Peace-ADIKEPETO/ExtDE0_7Seg-KiCad/7Seg_Ext.csv

Reference | Qty | Value | DNP | Exclude from BOM | Exclude from Board | Exclude from Simulation | Exclude from Position Files | Footprint | Datasheet
D1,D2,D3,D4,D5,D6,D7,D8,D9,D10,D11,D12 | 12 | LED |  |  |  |  | ${EXCLUDE_FROM_POS_FILES} | LED_THT:LED_D3.0mm
J1 | 1 | Conn_02x20_Odd_Even |  |  |  |  | ${EXCLUDE_FROM_POS_FILES} | Connector_PinSocket_2.54mm:PinSocket_2x20_P2.54mm_Vertical
Q1,Q6,Q7,Q8,Q9,Q10,Q11,Q12,Q13,Q14,Q15,Q16 | 12 | IRF9520 |  |  |  |  | ${EXCLUDE_FROM_POS_FILES} | Package_TO_SOT_THT:TO-220-3_Vertical
Q2,Q3,Q4,Q5 | 4 | 2N7000 |  |  |  |  | ${EXCLUDE_FROM_POS_FILES} | Package_TO_SOT_THT:TO-92_Inline | https://www.vishay.com/docs/70226/70226.pdf
R1,R2,R3,R4,R5,R6,R7,R8,R13,R16,R18,R20,R22,R24,R26,R28 | 16 | 330R |  |  |  |  | ${EXCLUDE_FROM_POS_FILES} | Resistor_THT:R_Axial_DIN0207_L6.3mm_D2.5mm_P10.16mm_Horizontal
R9,R10,R11,R12 | 4 | 100R |  |  |  |  | ${EXCLUDE_FROM_POS_FILES} | Resistor_THT:R_Axial_DIN0207_L6.3mm_D2.5mm_P7.62mm_Horizontal
R14,R15,R17,R19,R21,R23,R25,R27,R29,R32,R34,R36 | 12 | 1K |  |  |  |  | ${EXCLUDE_FROM_POS_FILES} | Resistor_THT:R_Axial_DIN0207_L6.3mm_D2.5mm_P7.62mm_Horizontal
R30,R31,R33,R35,R37,R38,R39,R40,R41 | 9 | 4.7K |  |  |  |  | ${EXCLUDE_FROM_POS_FILES} | Resistor_THT:R_Axial_DIN0207_L6.3mm_D2.5mm_P7.62mm_Horizontal
SW1 | 1 | SW_DIP_x08 |  |  |  |  | ${EXCLUDE_FROM_POS_FILES} | Button_Switch_THT:SW_DIP_SPSTx08_Slide_9.78x22.5mm_W7.62mm_P2.54mm
SW2,SW3,SW4,SW5 | 4 | SW_Push |  |  |  |  | ${EXCLUDE_FROM_POS_FILES} | Button_Switch_THT:SW_PUSH_6mm
SW6 | 1 | SMD-BUTTON_6P-10X10X8.6MM_ |  |  |  |  | ${EXCLUDE_FROM_POS_FILES} | SnapEDA:SW6-3.25-10X10X8.6MM
U1 | 1 | CC56-12EWA |  |  |  |  | ${EXCLUDE_FROM_POS_FILES} | Display_7Segment:CA56-12EWA | http://www.kingbrightusa.com/images/catalog/SPEC/CA56-12EWA.pdf
