Peace-ADIKEPETO/ExtDE0_7Seg-KiCad/7Seg_Ext.step

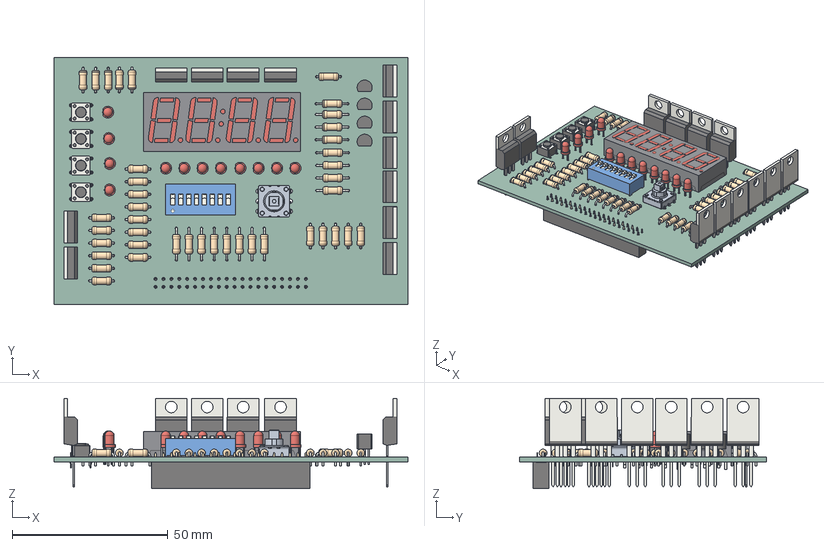
[picture p4: CAD file, 2026-10-20]
7Seg_Ext.step
113.7 x 79.3 x 29.0 mm
R_Axial_DIN0207_L63mm_D25mm_P762mm_Horizontal x 25
SW_PUSH_6mm x 4
TO-220-3_Vertical x 12
LED_D3.0mm x 12
TO-92_Inline_Narrow x 4
R_Axial_DIN0207_L63mm_D25mm_P1016mm_Horizontal x 16
Body_sp
SW_DIP_SPSTx08_Slide_978x225mm_W762mm_P254mm
PinSocket_2x20_P2.54mm_Vertical
7Se13B9_PCB
