Peace-ADIKEPETO/ExtDE0_7Seg-KiCad/(list of files, cad)

Other CAD files:
7Seg_Ext.stl
