Peace-ADIKEPETO/ExtDE0_7Seg-KiCad/docs/ExtDE0_7Seg.PDF

Comment | Description | Designator | Footprint | LibRef | Quantity
LED_Y | | D1 | D_0603_LED_Y | LED_Y | 1
LED_G | | D2 | D_0603_LED_G | LED_G | 1
LED_O | | D3 | D_0603_LED_O | LED_O | 1
LED_R | | D4, D5, D6, D7, D8, D9, D10, D11, D12 | D_0603_LED_R | LED_R | 9
Header 20X2 | Header, 20-Pin, Dual row | P1 | Header 40p 2x20 hole F, fem Draw | Header 20X2 | 1
0 | Resistor | R1, R2, R4, R5, R8, R9 | R_0603-thin | Res2 | 6
1K | Resistor | R3 | R_0603-thin | Res2 | 1
56 | ResNet x4 | R6, R7 | RESNETX4_0603_3216 M | Rx4_0603_3216M | 2
4.7k | Resistor | R10, R11, R12, R13, R14, R15, R17, R19, R21 | R_0603 | Res2 | 9
1k | Resistor | R16, R20, R22 | R_0603 | Res2 | 3
560 | Resistor | R18 | R_0603 | Res2 | 1
1k | ResNet x4 | R23, R25 | ResNetx4_0603_3216M | Rx4_0603_3216M | 2
330 | ResNet x4 | R24, R26, R27, R28 | ResNetx4_0603_3216M | Rx4_0603_3216M | 4
100 | Resistor | R29, R30, R31, R32, R33, R34 | R_0603-thin | Res2 | 6
SKQUDBE010 | SKQUDBE010-ALPS | S1 | SKQUDBE010 | Joystick_5P | 1
PushButton1_4p | [NoValue], [NoValue], [NoValue], PushButton | S2, S3, S4, S5 | FSM4JSMA | PushButton1_4p | 4
Switch8p_On_Tri_On | | S6 | SOP254P990X265-16N | Switch8p_On_Tri_On | 1
pMOS | | T1, T2, T3, T4, T5, T6 | SSSMINI3-F2-B | pMOS | 6
nMOS | | T7, T8, T9, T10, T11, T12, T13, T14, T15, T16, T17, T18, T19, T20 | SSSMINI3-F2-B | nMOS | 14
TP | | TP1, TP2 | TP_0.75mm | TP | 2
7SEG_6Digit_KEM-3061-ASR | | U1 | 7SEG_6DIGI_7.68MM | 7SEG_6Digit_KEM-3061-ASR | 1
7SEG_4Digit_LTC4627JR 7SEG 4DIGI Annode CommU2 | | | 7SEG_4DIGI_10MM_LTC7SEG_4 Digit_LTC4627JR | | 1

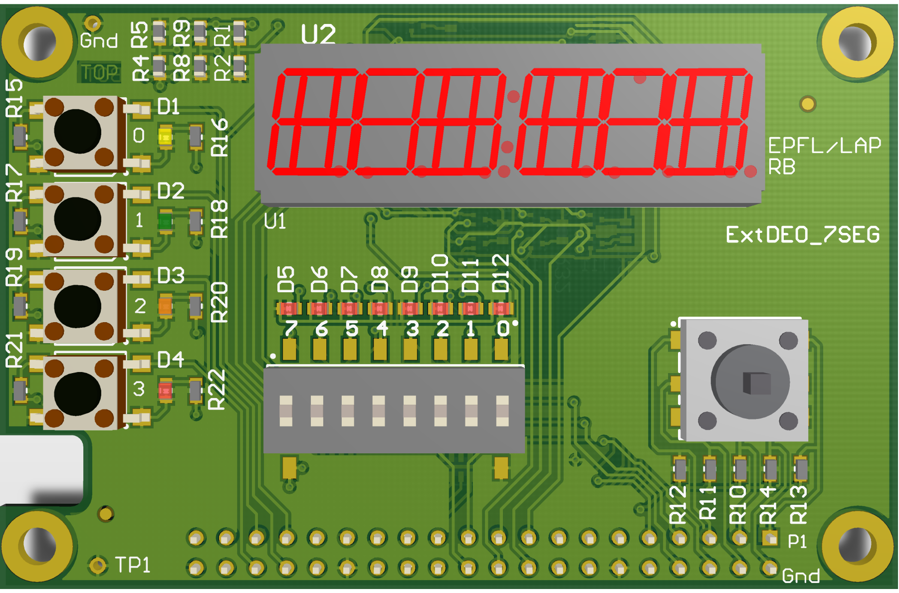
[picture p5: page 2]

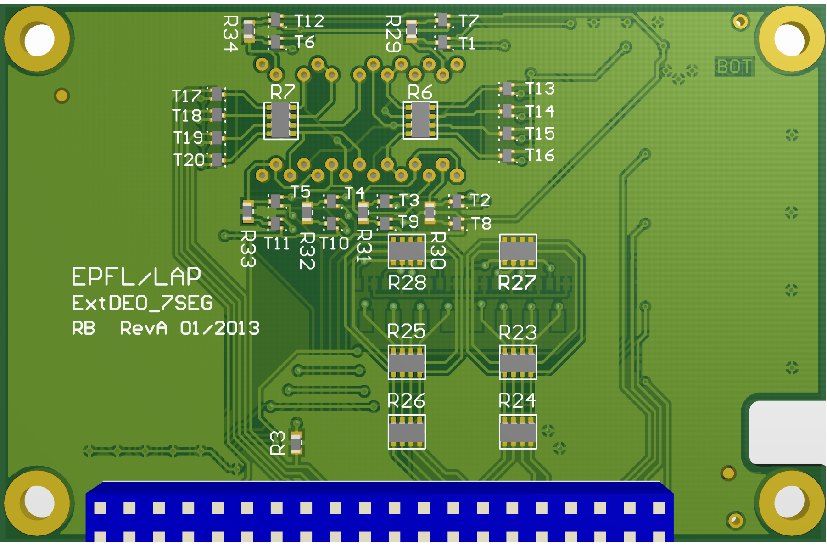
[picture p6: page 3]

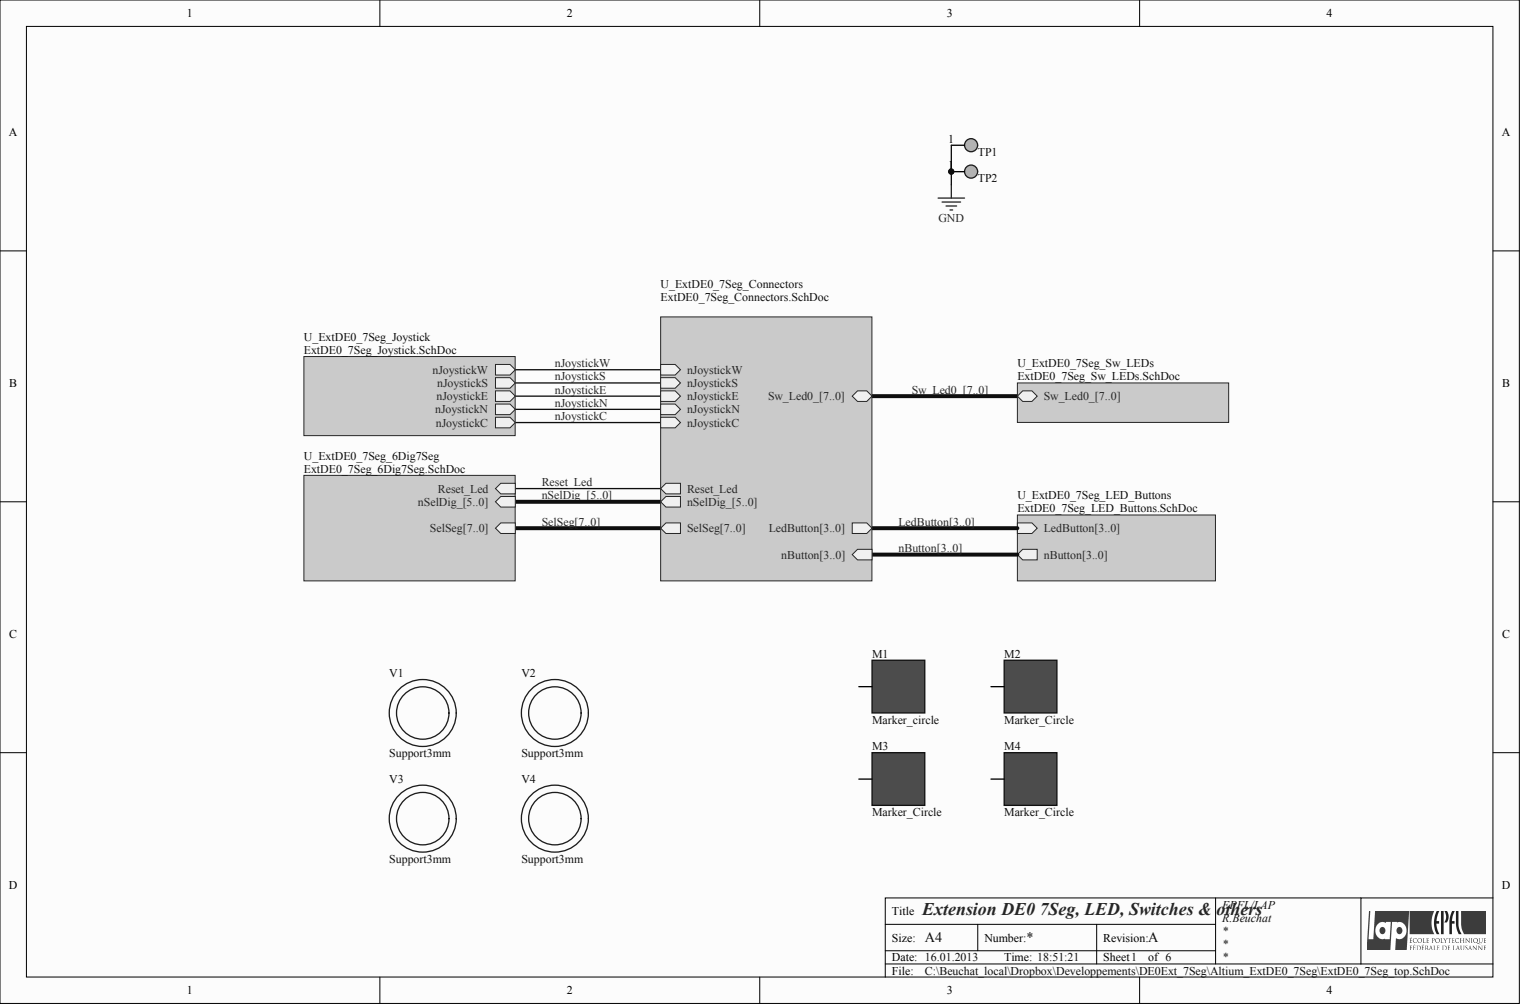
[picture p7: page 4]

Extension DE0 7Seg, LED, Switches & others Title | EPFL/LAP R.Beuchat * *

A4 Size: | * Number: | A Revision:
Date: 16.01.2013 Time: 18:51:21 | | Sheet of 6

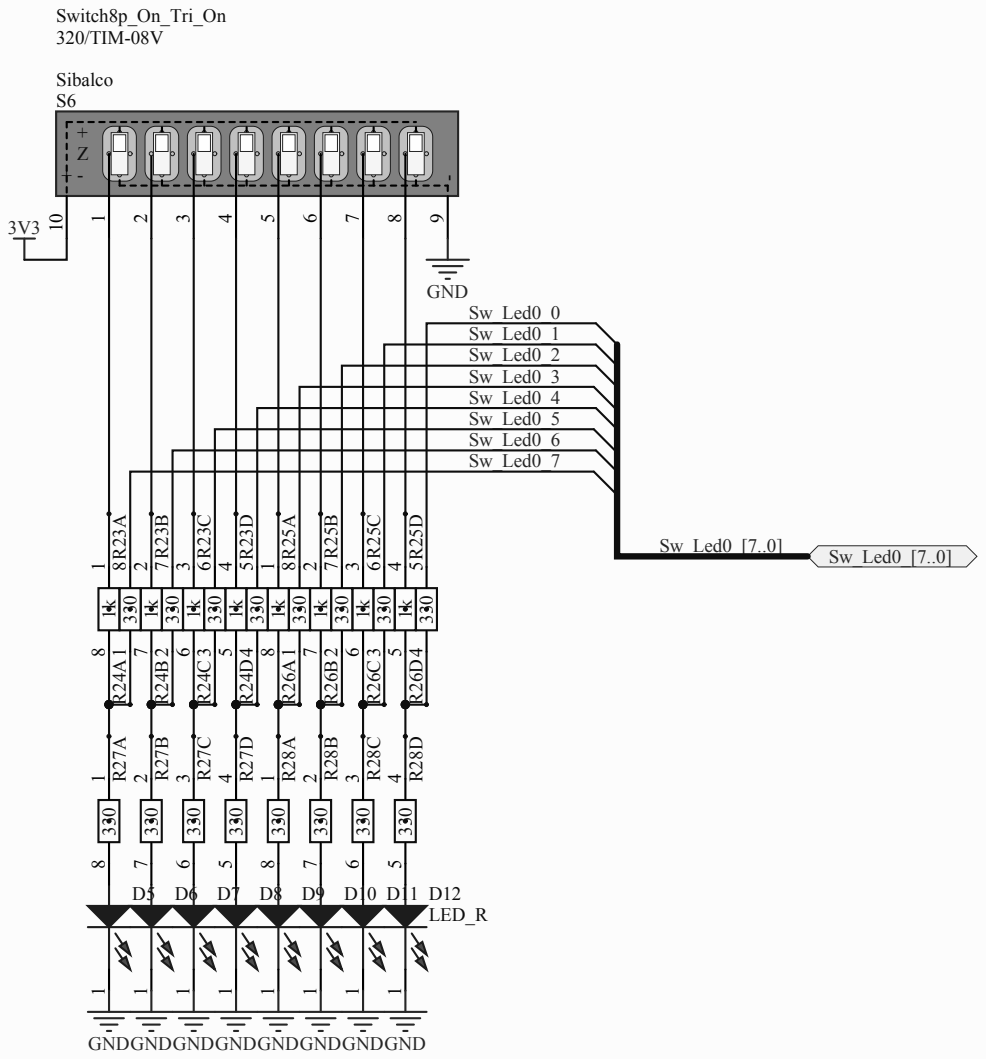
[picture p8: page 5]

Sw_Led0_2
Sw_Led0_3
Sw_Led0_4
Sw_Led0_5
Sw_Led0_6
Sw_Led0_7

Extension DE0 LED, Switches & others Title | EPFL/LAP R.Beuchat *

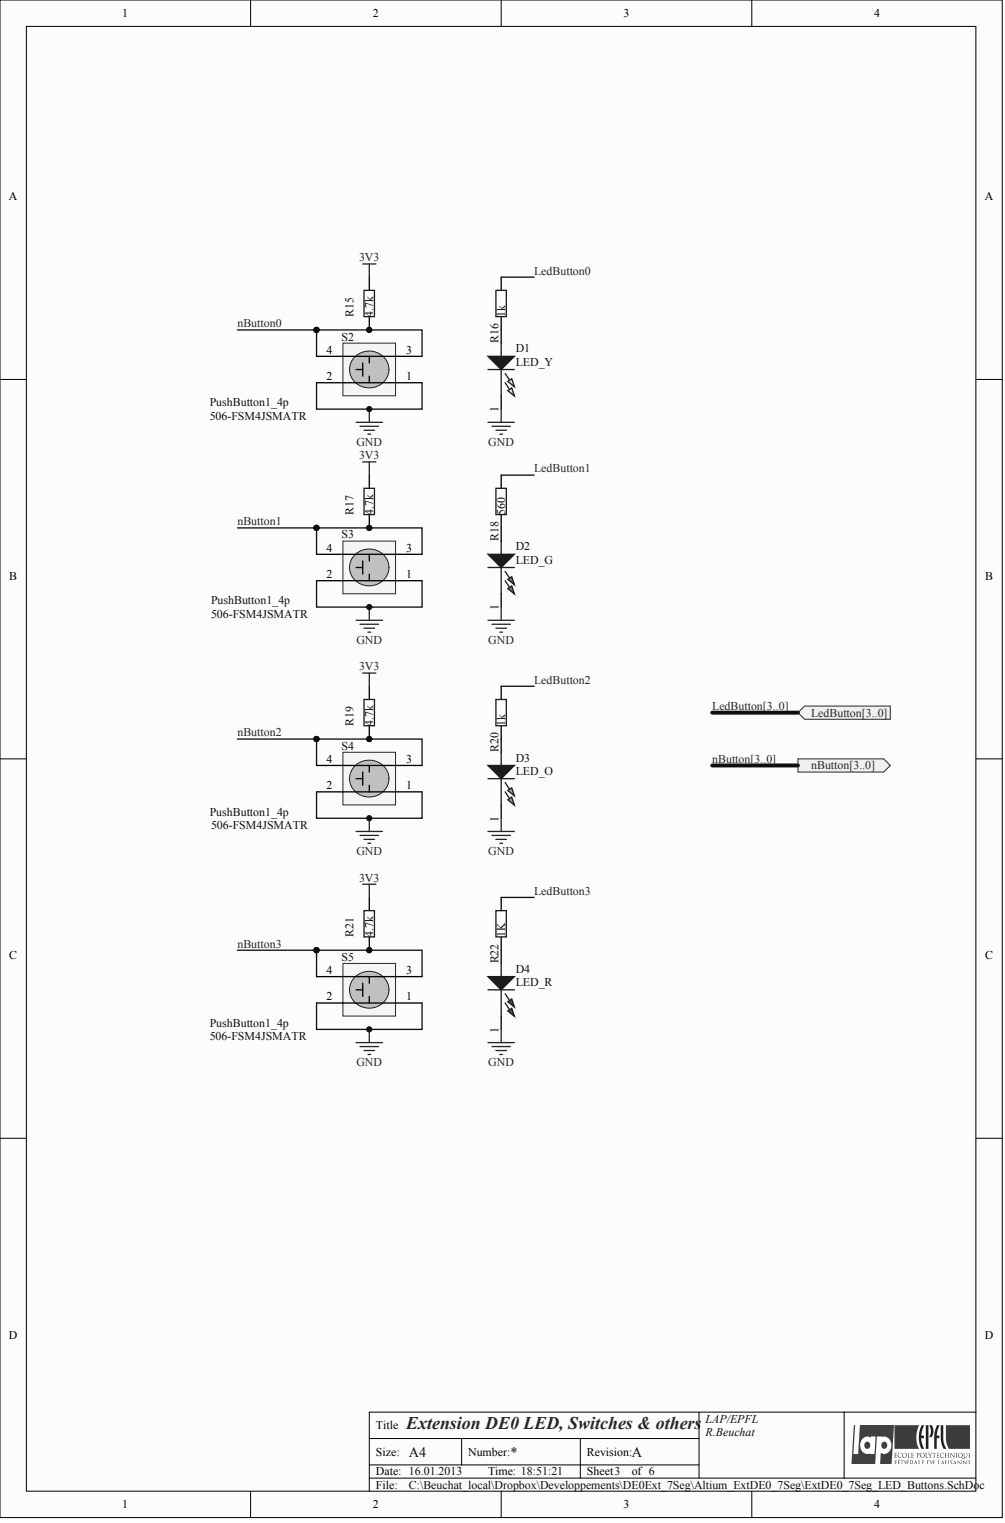
[picture p9: page 6]

Extension DE0 LED, Switches & others | LAP/EPFL R.Beuchat

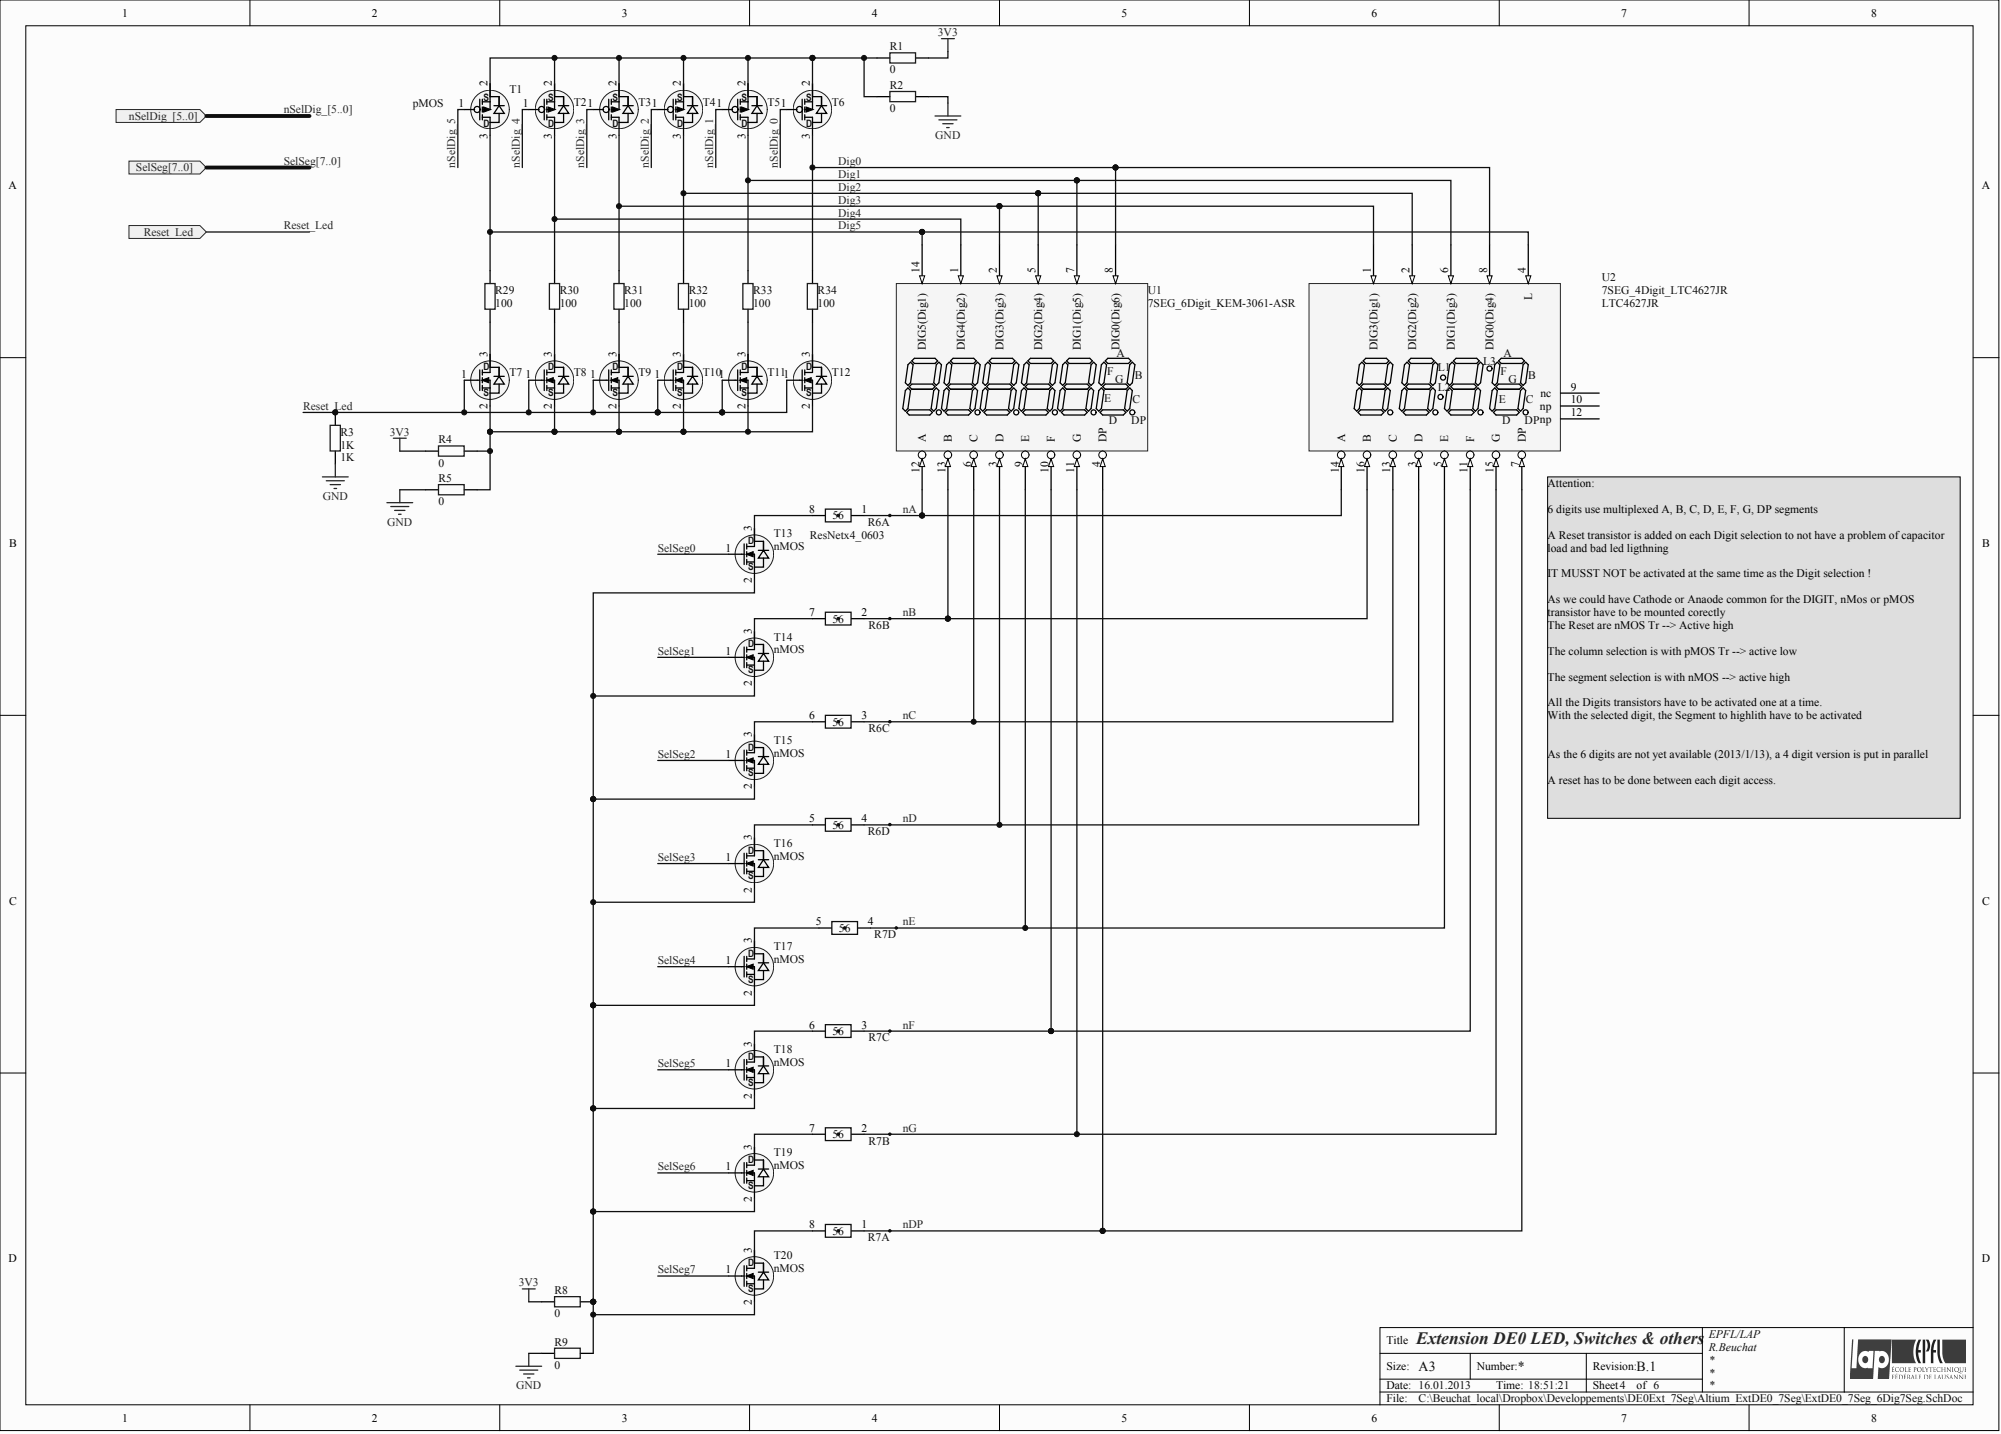
[picture p10: page 7]

Dig 1
Dig 2
Dig 3
Dig 4
Dig 5

6 digits use multiplexed A, B, C, D, E, F, G, DP seg

A Reset transistor is added on each Digit selection to not have a problem of capacitor
load and bad led ligthning IT MUSST NOT be activated at the same time as the Digit selection !

As we could have Cathode or Anaode com
transistor have to be mounted corectly
The Reset are nMOS Tr -

mon for the DIGIT, nMos or pMOS

The column selection is with pMOS Tr -

ment selection is with nMOS -

All the Digits transistors have to be activated one at a time.
With the selected digit, the Seg

ment to highlith have to be activated

As the 6 digits are not yet available (2013/1/13), a 4 digit version is put in parallel

A reset has to be done between each digit access.

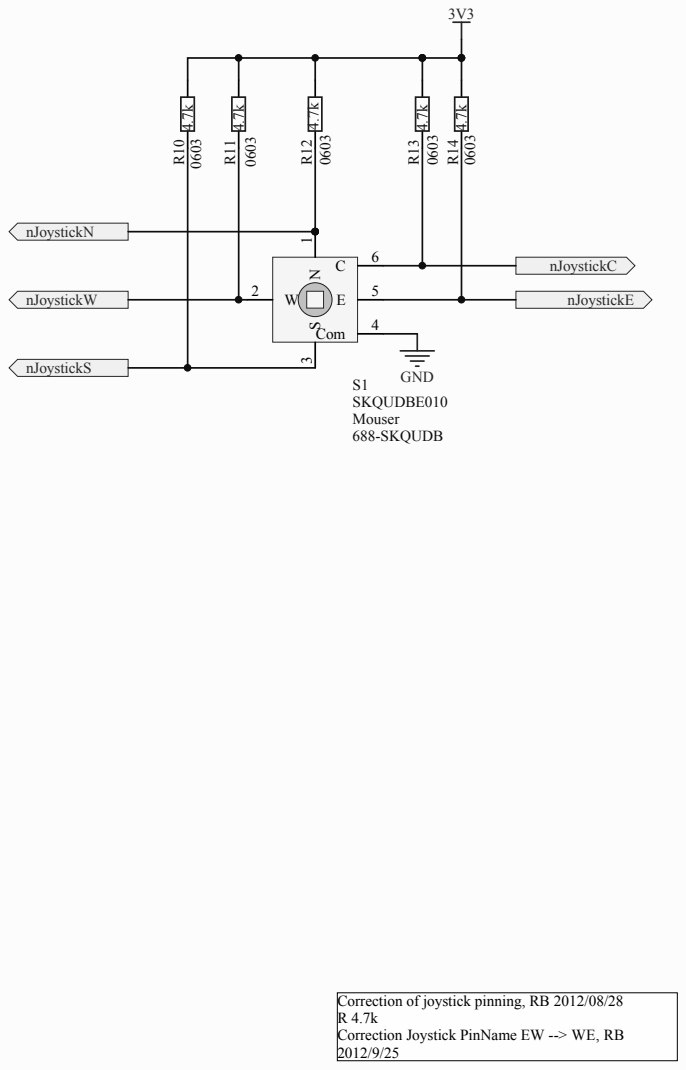
[picture p11: page 8]

Correction of joystick pinning, RB 2012/08/28
Correction Joystick PinName EW --> WE, RB

Extension DE0 LED, Switches & others | LAP/EPFL R.Beuchat Joystick

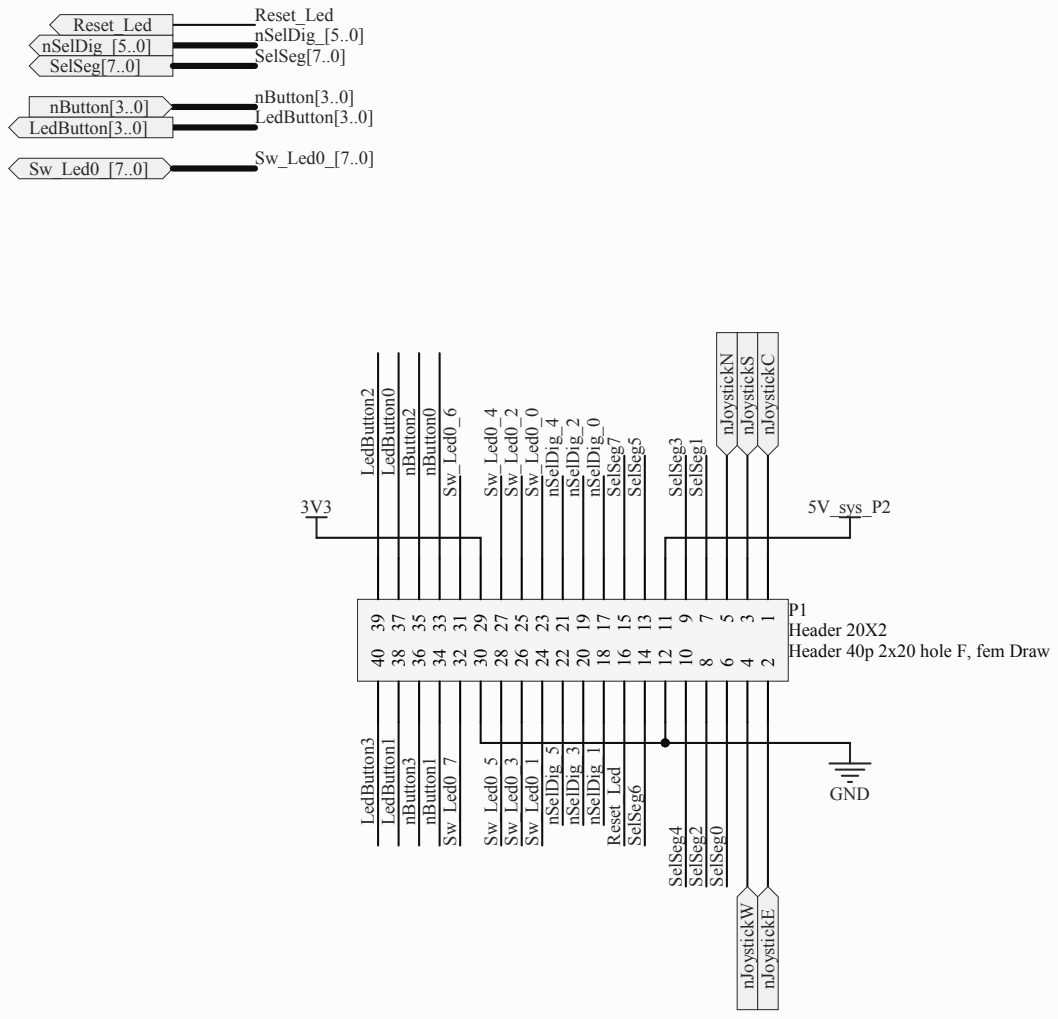
[picture p12: page 9]

Extension DE0 7Seg, Switches & others Title | EPFL/LAP R.Beuchat *
