Peace-ADIKEPETO/ExtDE0_7Seg-KiCad/7Seg_Ext-B_Cu.pdf

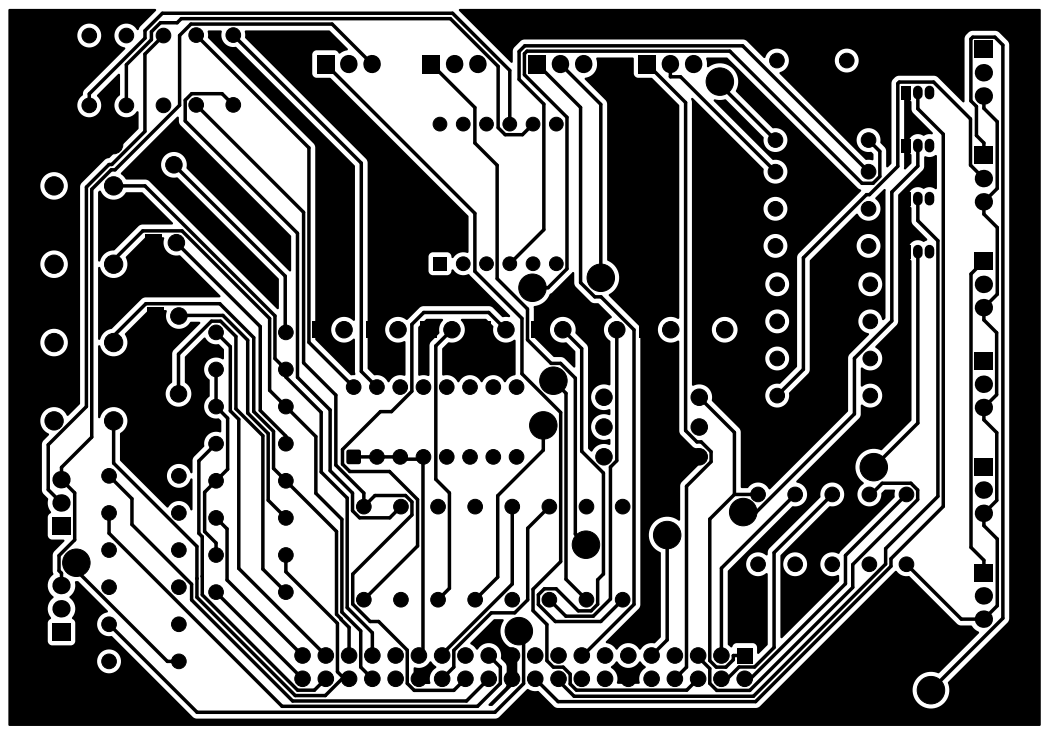
[picture p13: page 1]
