Peace-ADIKEPETO/ExtDE0_7Seg-KiCad/7Seg_Ext-B_Mask.pdf

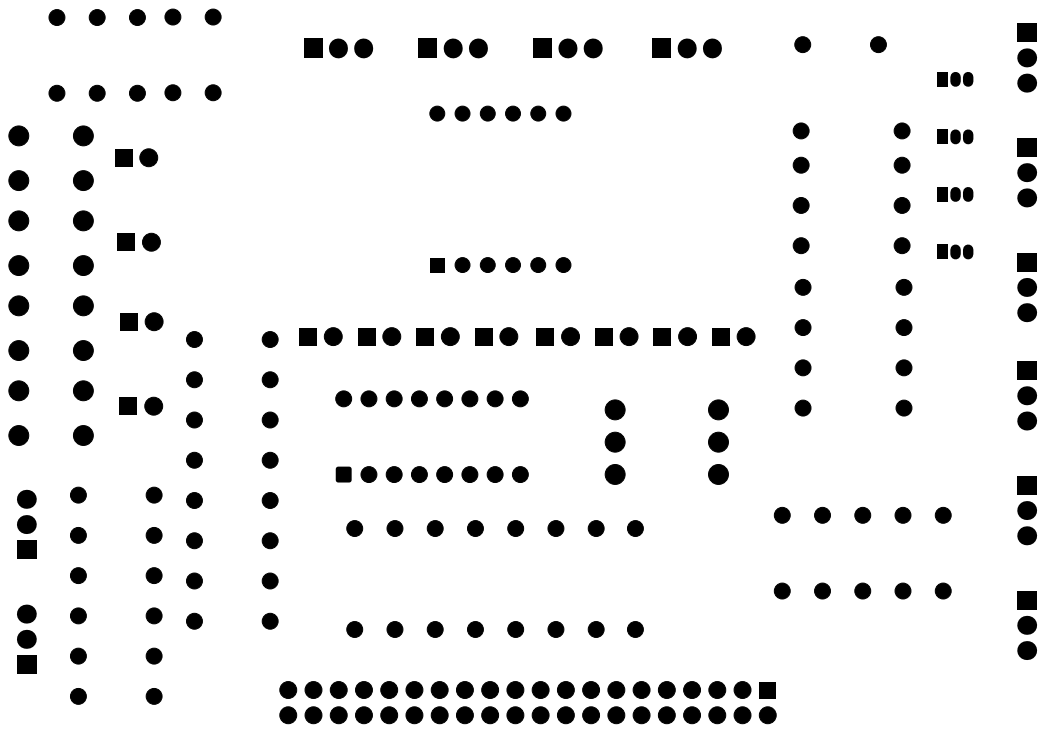
[picture p14: page 1]
