Peace-ADIKEPETO/ExtDE0_7Seg-KiCad/7Seg_Ext-F_Cu.pdf

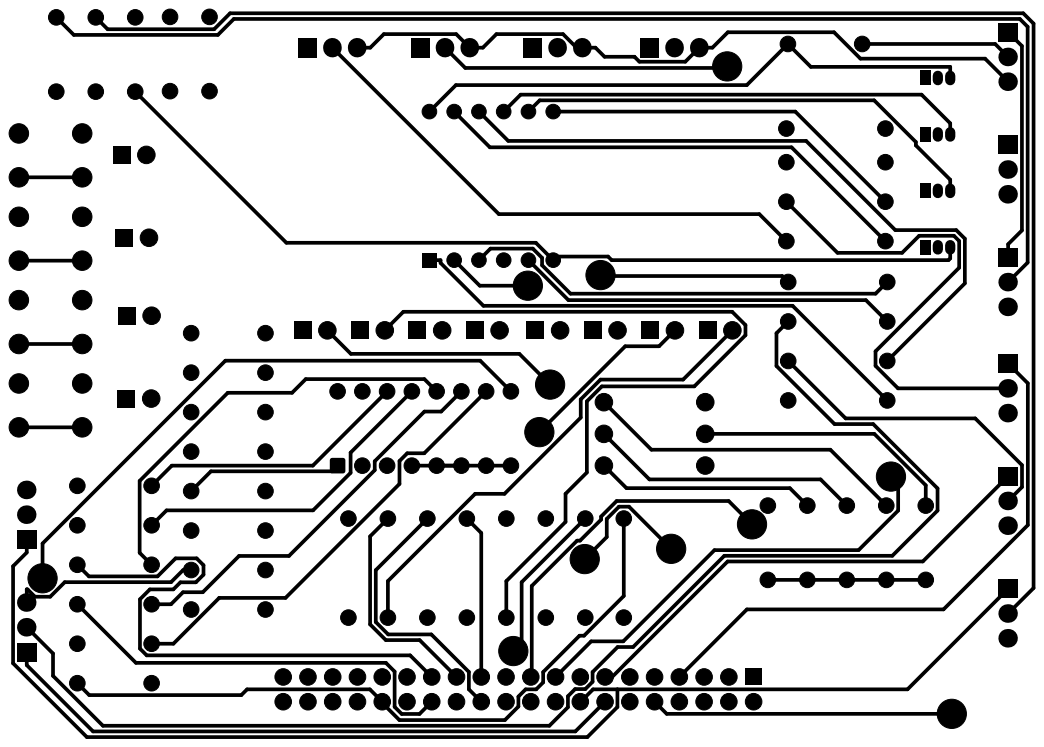
[picture p15: page 1]
