Peace-ADIKEPETO/ExtDE0_7Seg-KiCad/7Seg_Ext-F_Silkscreen.pdf

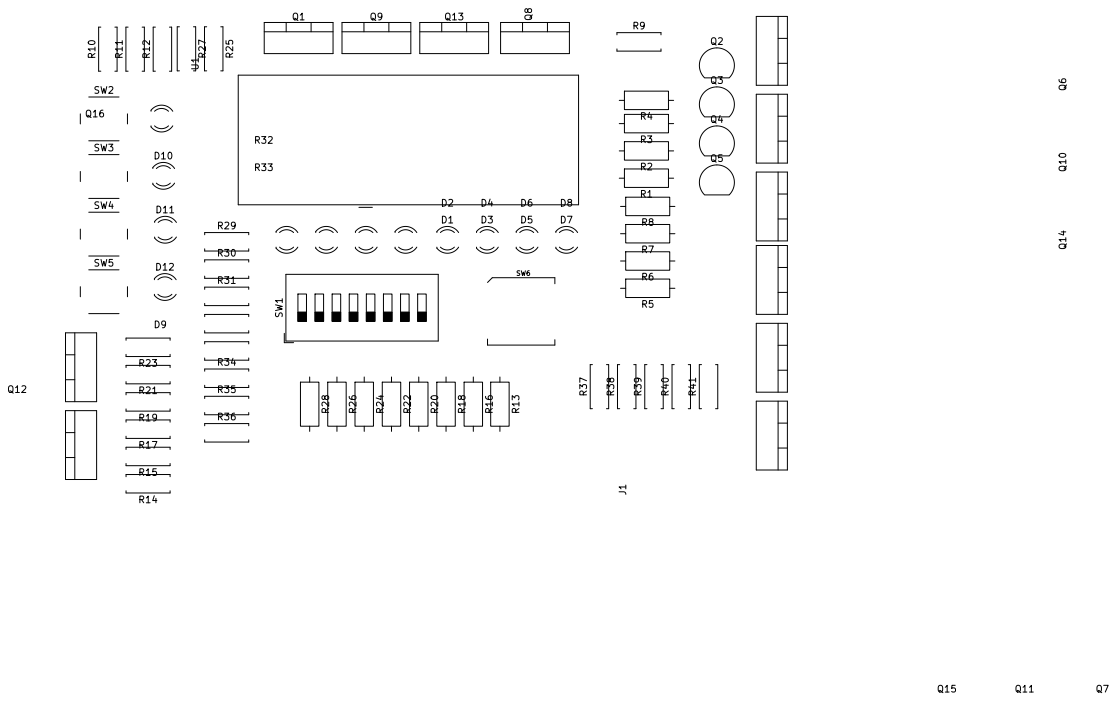
[picture p16: page 1]
