Peace-ADIKEPETO/ExtDE0_7Seg-KiCad/(list of files, drawings)

Other design files:
temp-freerouting.dsn
