Peace-ADIKEPETO/ExtDE0_7Seg-KiCad/7Seg_Ext.kicad_pcb

## KiCad design 7Seg_Ext.kicad_pcb (2026-10-20)

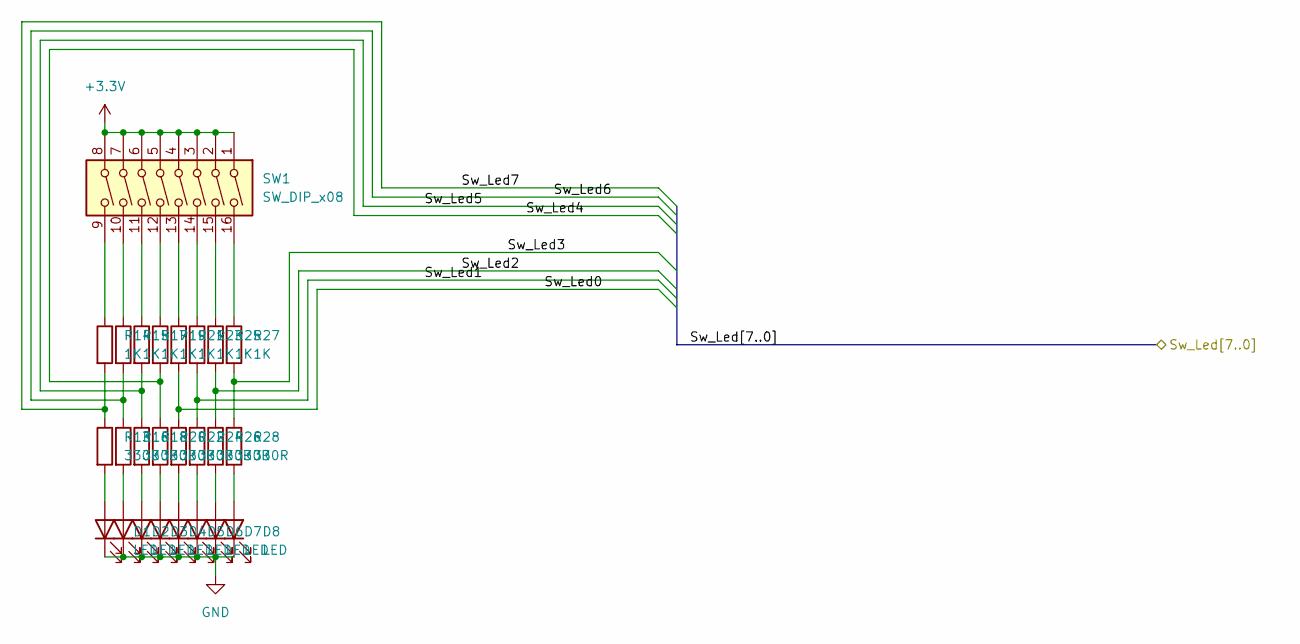
[picture p17: schematic Sheet2.kicad_sch]

Parts:
D1, D2, D3, D4, D5, D6, D7, D8: LED; LED_D3.0mm
R13, R16, R18, R20, R22, R24, R26, R28: 330R; R_Axial_DIN0207_L6.3mm_D2.5mm_P10.16mm_Horizontal
R14, R15, R17, R19, R21, R23, R25, R27: 1K; R_Axial_DIN0207_L6.3mm_D2.5mm_P7.62mm_Horizontal
SW1: SW_DIP_x08; SW_DIP_SPSTx08_Slide_9.78x22.5mm_W7.62mm_P2.54mm

Connections:
+3.3V: SW1.1, SW1.2, SW1.3, SW1.4, SW1.5, SW1.6, SW1.7, SW1.8; also elsewhere on the board
/Sw_Led0: R21.2, R22.1; also elsewhere on the board
/Sw_Led1: R23.2, R24.1; also elsewhere on the board
/Sw_Led2: R25.2, R26.1; also elsewhere on the board
/Sw_Led3: R27.2, R28.1; also elsewhere on the board
/Sw_Led4: R19.2, R20.1; also elsewhere on the board
/Sw_Led5: R17.2, R18.1; also elsewhere on the board
/Sw_Led6: R15.2, R16.1
/Sw_Led7: R13.1, R14.2; also elsewhere on the board
GND: D1.1 (K), D2.1 (K), D3.1 (K), D4.1 (K), D5.1 (K), D6.1 (K), D7.1 (K), D8.1 (K); also elsewhere on the board
unnamed: D1.2 (A), R13.2
unnamed: D2.2 (A), R16.2
unnamed: D3.2 (A), R18.2
unnamed: D4.2 (A), R20.2
unnamed: D5.2 (A), R22.2
unnamed: D6.2 (A), R24.2
unnamed: D7.2 (A), R26.2
unnamed: D8.2 (A), R28.2
unnamed: R14.1, SW1.9
unnamed: R15.1, SW1.10
unnamed: R17.1, SW1.11
unnamed: R19.1, SW1.12
unnamed: R21.1, SW1.13
unnamed: R23.1, SW1.14
unnamed: R25.1, SW1.15
unnamed: R27.1, SW1.16

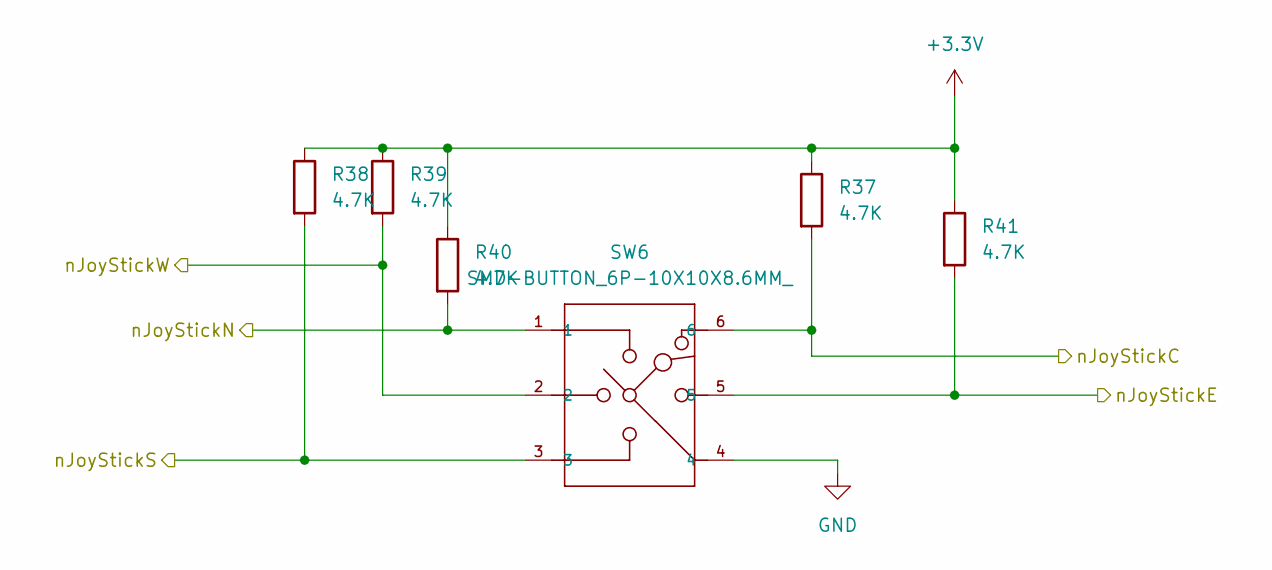
[picture p18: schematic Sheet4.kicad_sch]

Parts:
R37, R38, R39, R40, R41: 4.7K; R_Axial_DIN0207_L6.3mm_D2.5mm_P7.62mm_Horizontal
SW6: SMD-BUTTON_6P-10X10X8.6MM_; SW6-3.25-10X10X8.6MM

Connections:
+3.3V: R37.1, R38.1, R39.1, R40.1, R41.1; also elsewhere on the board
/nJoyStickC: R37.2, SW6.6; also elsewhere on the board
/nJoyStickE: R41.2, SW6.5; also elsewhere on the board
/nJoyStickN: R40.2, SW6.1; also elsewhere on the board
/nJoyStickS: R38.2, SW6.3; also elsewhere on the board
/nJoyStickW: R39.2, SW6.2; also elsewhere on the board
GND: SW6.4; also elsewhere on the board

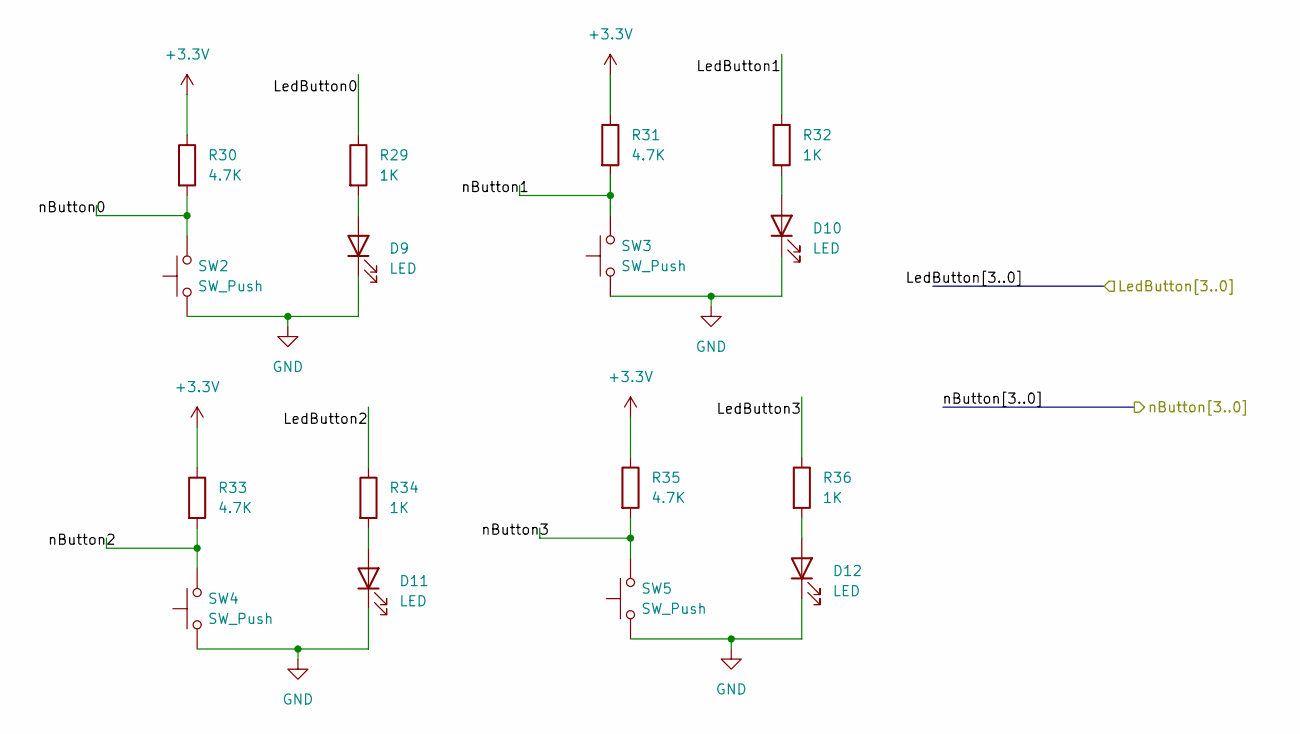
[picture p19: schematic Sheet3.kicad_sch]

Parts:
D9, D10, D11, D12: LED; LED_D3.0mm
R29, R32, R34, R36: 1K; R_Axial_DIN0207_L6.3mm_D2.5mm_P7.62mm_Horizontal
R30, R31, R33, R35: 4.7K; R_Axial_DIN0207_L6.3mm_D2.5mm_P7.62mm_Horizontal
SW2, SW3, SW4, SW5: SW_Push; SW_PUSH_6mm

Connections:
+3.3V: R30.1, R31.1, R33.1, R35.1; also elsewhere on the board
/LedButton0: R29.1; also elsewhere on the board
/LedButton1: R32.1; also elsewhere on the board
/LedButton2: R34.1; also elsewhere on the board
/LedButton3: R36.1; also elsewhere on the board
/nButton0: R30.2, SW2.2; also elsewhere on the board
/nButton1: R31.2, SW3.2; also elsewhere on the board
/nButton2: R33.2, SW4.2; also elsewhere on the board
/nButton3: R35.2, SW5.2; also elsewhere on the board
GND: D9.1 (K), D10.1 (K), D11.1 (K), D12.1 (K), SW2.1, SW3.1, SW4.1, SW5.1; also elsewhere on the board
unnamed: D9.2 (A), R29.2
unnamed: D10.2 (A), R32.2
unnamed: D11.2 (A), R34.2
unnamed: D12.2 (A), R36.2

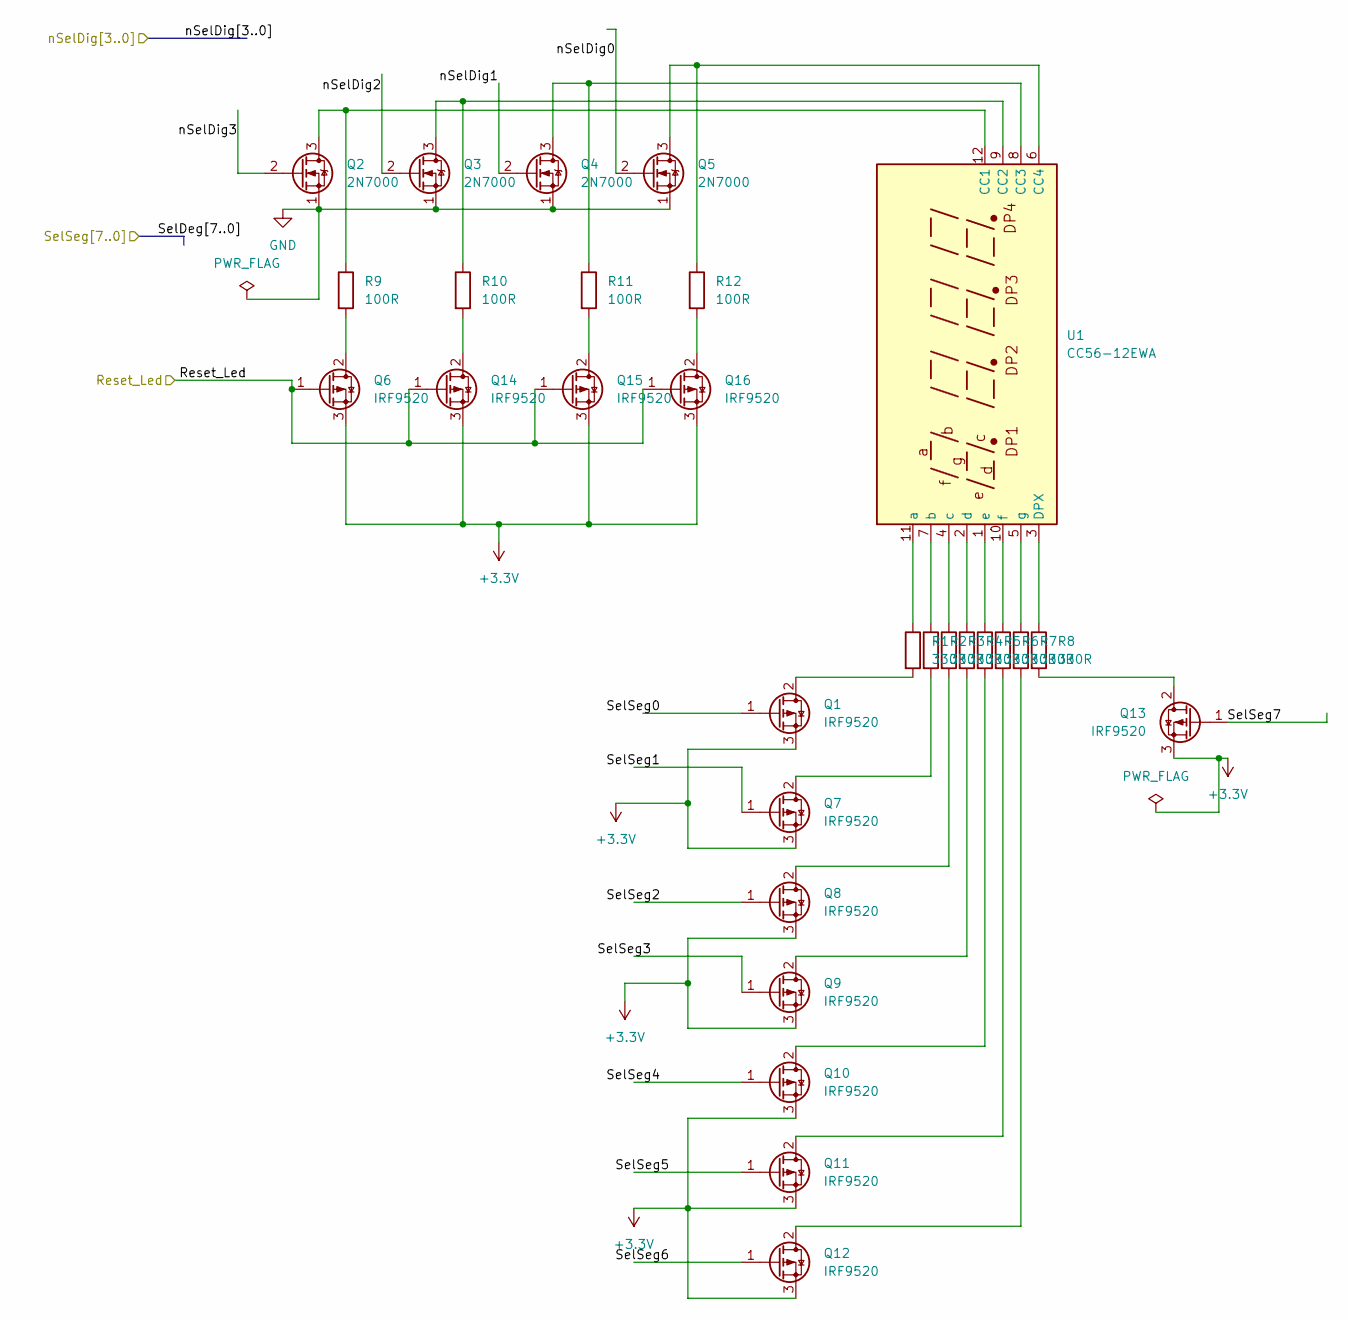
[picture p20: schematic Sheet1.kicad_sch]

Parts:
Q1, Q6, Q7, Q8, Q9, Q10, Q11, Q12, Q13, Q14, Q15, Q16: IRF9520; TO-220-3_Vertical
Q2, Q3, Q4, Q5: 2N7000; TO-92_Inline
R1, R2, R3, R4, R5, R6, R7, R8: 330R; R_Axial_DIN0207_L6.3mm_D2.5mm_P10.16mm_Horizontal
R9, R10, R11, R12: 100R; R_Axial_DIN0207_L6.3mm_D2.5mm_P7.62mm_Horizontal
U1: CC56-12EWA; CA56-12EWA

Connections:
+3.3V: Q1.3 (S), Q6.3 (S), Q7.3 (S), Q8.3 (S), Q9.3 (S), Q10.3 (S), Q11.3 (S), Q12.3 (S), Q13.3 (S), Q14.3 (S), Q15.3 (S), Q16.3 (S); also elsewhere on the board
/Reset_Led: Q6.1 (G), Q14.1 (G), Q15.1 (G), Q16.1 (G); also elsewhere on the board
/SelSeg0: Q1.1 (G); also elsewhere on the board
/SelSeg1: Q7.1 (G); also elsewhere on the board
/SelSeg2: Q8.1 (G); also elsewhere on the board
/SelSeg3: Q9.1 (G); also elsewhere on the board
/SelSeg4: Q10.1 (G); also elsewhere on the board
/SelSeg5: Q11.1 (G); also elsewhere on the board
/SelSeg6: Q12.1 (G); also elsewhere on the board
/SelSeg7: Q13.1 (G); also elsewhere on the board
/nSelDig0: Q5.2 (G); also elsewhere on the board
/nSelDig1: Q4.2 (G); also elsewhere on the board
/nSelDig2: Q3.2 (G); also elsewhere on the board
/nSelDig3: Q2.2 (G); also elsewhere on the board
GND: Q2.1 (S), Q3.1 (S), Q4.1 (S), Q5.1 (S); also elsewhere on the board
unnamed: Q1.2 (D), R1.2
unnamed: Q2.3 (D), R9.1, U1.12 (CC1)
unnamed: Q3.3 (D), R10.1, U1.9 (CC2)
unnamed: Q4.3 (D), R11.1, U1.8 (CC3)
unnamed: Q5.3 (D), R12.1, U1.6 (CC4)
unnamed: Q6.2 (D), R9.2
unnamed: Q7.2 (D), R2.2
unnamed: Q8.2 (D), R3.2
unnamed: Q9.2 (D), R4.2
unnamed: Q10.2 (D), R5.2
unnamed: Q11.2 (D), R6.2
unnamed: Q12.2 (D), R7.2
unnamed: Q13.2 (D), R8.2
unnamed: Q14.2 (D), R10.2
unnamed: Q15.2 (D), R11.2
unnamed: Q16.2 (D), R12.2
unnamed: R8.1, U1.3 (DPX)
unnamed: R1.1, U1.11 (a)
unnamed: R2.1, U1.7 (b)
unnamed: R3.1, U1.4 (c)
unnamed: R4.1, U1.2 (d)
unnamed: R5.1, U1.1 (e)
unnamed: R6.1, U1.10 (f)
unnamed: R7.1, U1.5 (g)

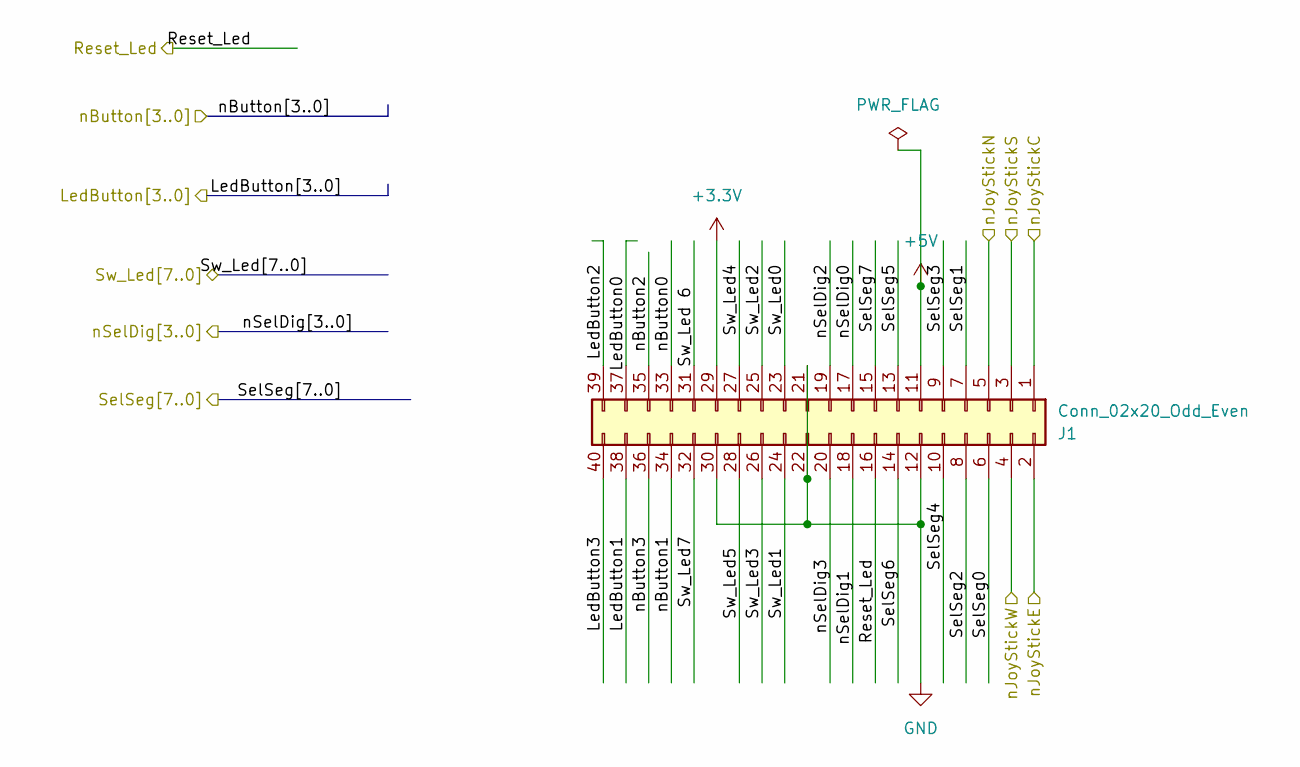
[picture p21: schematic Connectors.kicad_sch]

Parts:
J1: Conn_02x20_Odd_Even; PinSocket_2x20_P2.54mm_Vertical

Connections:
+3.3V: J1.29; also elsewhere on the board
+5V: J1.11
/Connectors/Sw_Led 6: J1.31
/LedButton0: J1.37; also elsewhere on the board
/LedButton1: J1.38; also elsewhere on the board
/LedButton2: J1.39; also elsewhere on the board
/LedButton3: J1.40; also elsewhere on the board
/Reset_Led: J1.16; also elsewhere on the board
/SelSeg0: J1.6; also elsewhere on the board
/SelSeg1: J1.7; also elsewhere on the board
/SelSeg2: J1.8; also elsewhere on the board
/SelSeg3: J1.9; also elsewhere on the board
/SelSeg4: J1.10; also elsewhere on the board
/SelSeg5: J1.13; also elsewhere on the board
/SelSeg6: J1.14; also elsewhere on the board
/SelSeg7: J1.15; also elsewhere on the board
/Sw_Led0: J1.23; also elsewhere on the board
/Sw_Led1: J1.24; also elsewhere on the board
/Sw_Led2: J1.25; also elsewhere on the board
/Sw_Led3: J1.26; also elsewhere on the board
/Sw_Led4: J1.27; also elsewhere on the board
/Sw_Led5: J1.28; also elsewhere on the board
/Sw_Led7: J1.32; also elsewhere on the board
/nButton0: J1.33; also elsewhere on the board
/nButton1: J1.34; also elsewhere on the board
/nButton2: J1.35; also elsewhere on the board
/nButton3: J1.36; also elsewhere on the board
/nJoyStickC: J1.1; also elsewhere on the board
/nJoyStickE: J1.2; also elsewhere on the board
/nJoyStickN: J1.5; also elsewhere on the board
/nJoyStickS: J1.3; also elsewhere on the board
/nJoyStickW: J1.4; also elsewhere on the board
/nSelDig0: J1.17; also elsewhere on the board
/nSelDig1: J1.18; also elsewhere on the board
/nSelDig2: J1.19; also elsewhere on the board
/nSelDig3: J1.20; also elsewhere on the board
GND: J1.12, J1.21, J1.22, J1.30; also elsewhere on the board

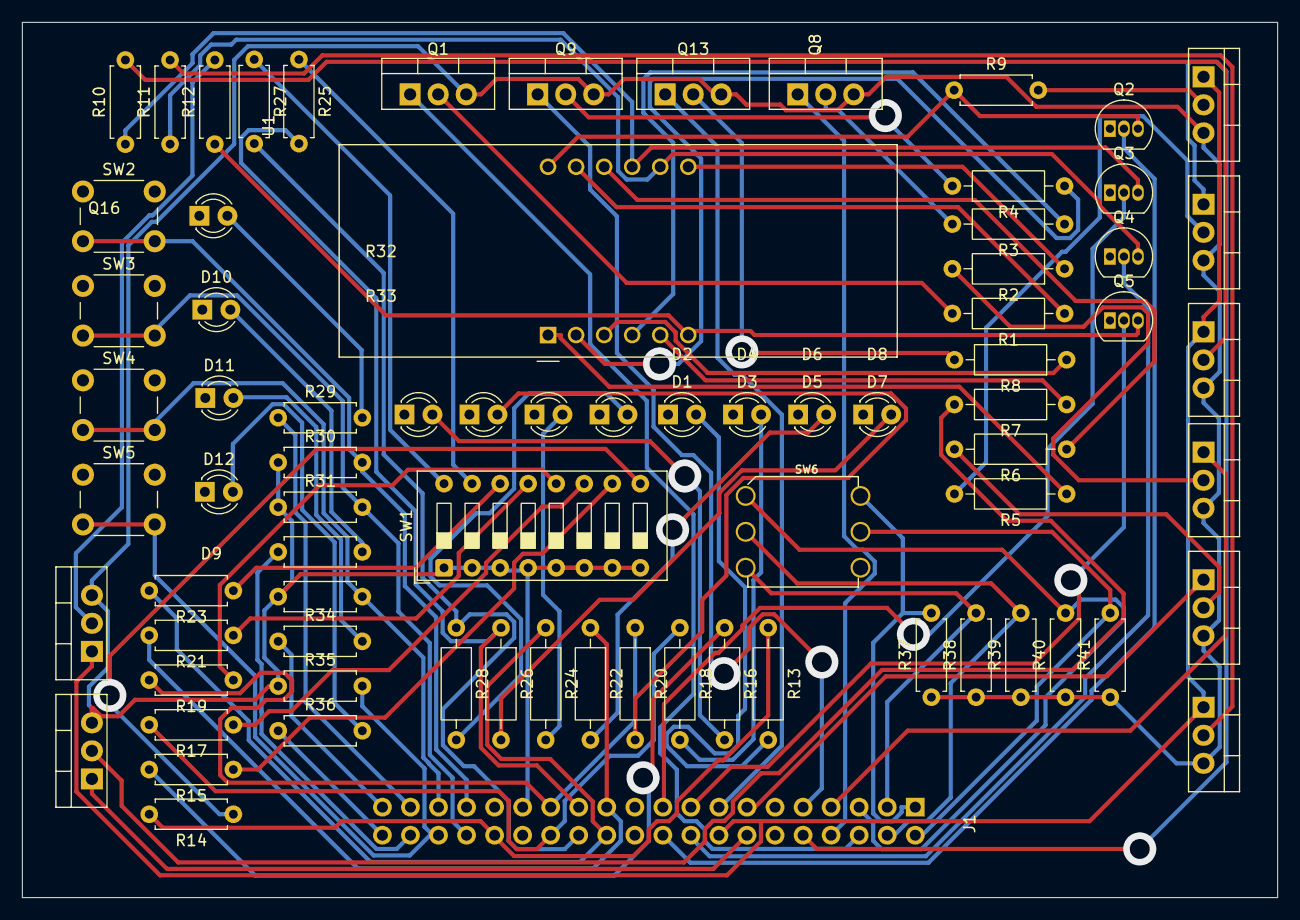
[picture p22: board 7Seg_Ext.kicad_pcb from above]

Board: 2 copper layers, 113.7 x 79.3 mm, 77 parts (1 on the bottom side), 80 nets.
